VGaer/flatbox/hardware-rev5-rgb/pcb/BOM.csv

No. | Quantity | Comment | Designator | Footprint | Value | Manufacturer Part | Manufacturer | Supplier Part | Supplier
1 | 1 | RP2040-Zero_RP2040-Zero | A1 | RP2040-Zero:RP2040-Zero | RP2040-Zero
2 | 1 | 100nF | C1 | C0603 | 100nF
3 | 6 | Mechanical_MountingHole | H1,H2,H3,H4,H5,H6 | MountingHole:MountingHole_6.4mm_M6 | MountingHole
4 | 12 | WS2812B-2020 | LED1,LED2,LED3,LED4,LED5,LED6,LED7,LED8,LED9,LED10,LED11,LED12 | LED-SMD_4P-L2.0-W2.0-TL_WS2812B-2020 |  | WS2812B-2020 | worldsemi | C965555 | LCSC
5 | 1 | 10K | R1 | R0603 | 10K
6 | 7 | TS-1002-AR05026 | SW1,SW2,SW3,SW4,SW5,SW6,SW7 | Button_Switch_THT:SW_PUSH_6mm_H5mm | SW_Push | TS-1002-AR05026 | XUNPU(讯普) | C2835251 | LCSC
7 | 12 |  | U1,U2,U3,U4,U5,U6,U7,U8,U9,U10,U11,U12 | Kailh_socket_PG1350
8 | 1 | SN74LV1T34DBVR | U13 | SOT-23-5_L3.0-W1.7-P0.95-LS2.8-BR |  | SN74LV1T34DBVR | TI(德州仪器) | C100024 | LCSC
