VGaer/flatbox/hardware-rev5-rgb/extras/arc v4.dxf

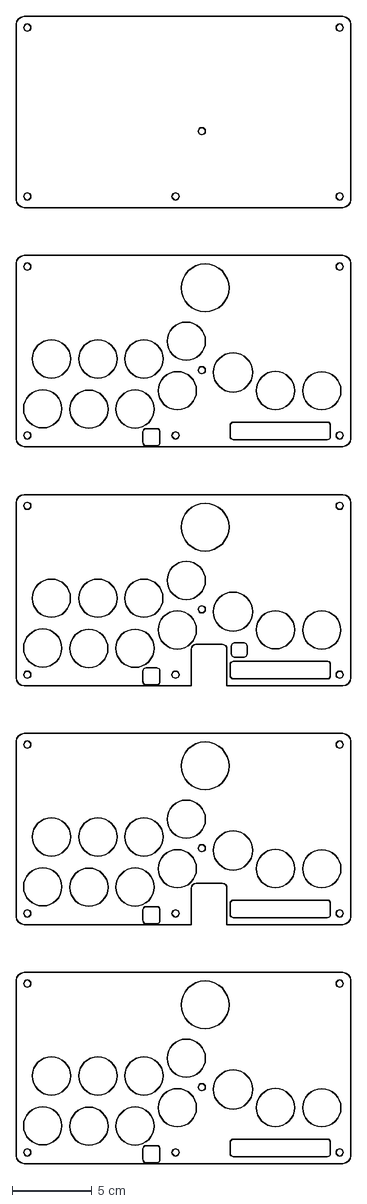
[picture p7: CAD file, 2023-06-08]
hardware-rev5-rgb/extras/arc v4.dxf
21.0 x 72.0 cm
