VGaer/flatbox/hardware-rev5-rgb/extras/Flatbox_cap_sprue.stl

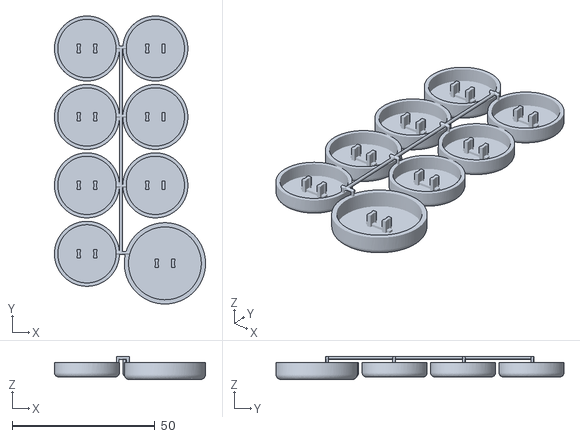
[picture p8: CAD file, 2023-06-07]
hardware-rev5-rgb/extras/Flatbox_cap_sprue.stl
53.0 x 101.0 x 8.12
