VGaer/flatbox/hardware-rev5-rgb/extras/test arc.dxf

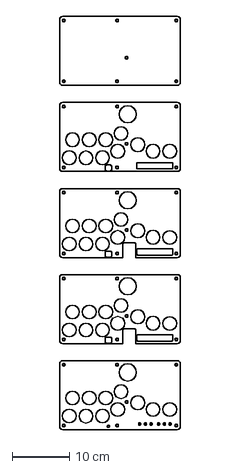
[picture p9: CAD file, 2023-05-07]
hardware-rev5-rgb/extras/test arc.dxf
21.0 x 72.0 cm
