VGaer/flatbox/hardware-rev5-rgb/extras/SCH_Schematic1_2023-03-26.pdf

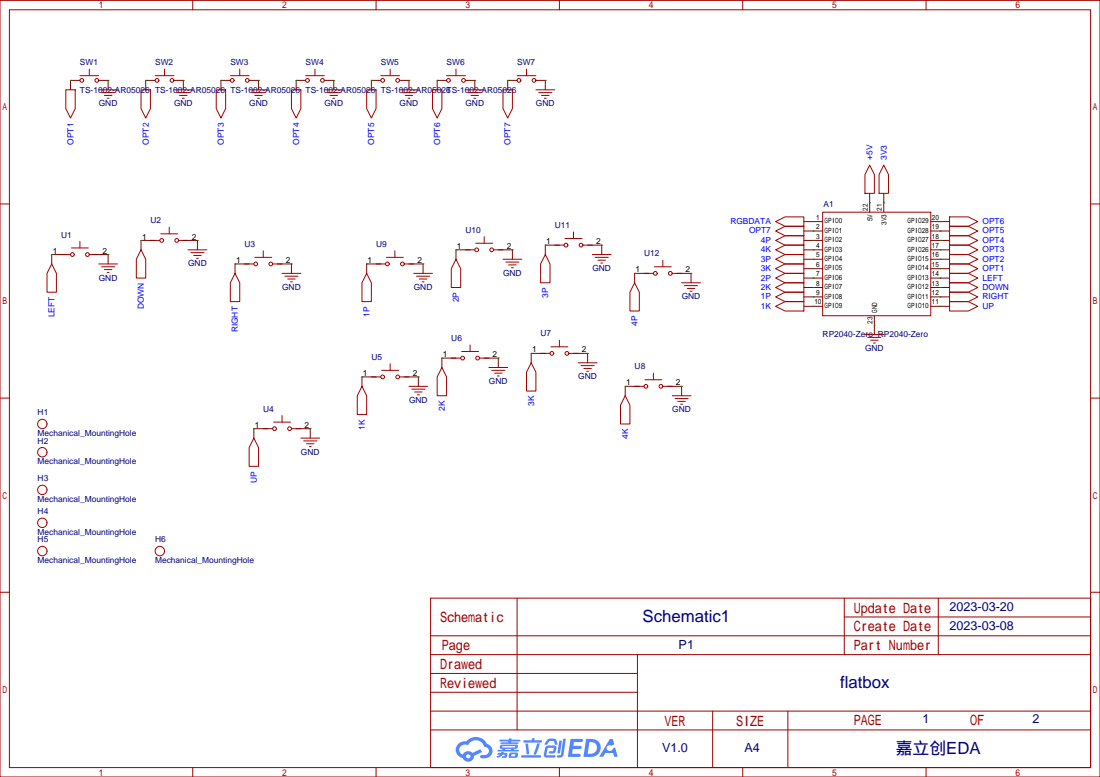
[picture p10: page 1]

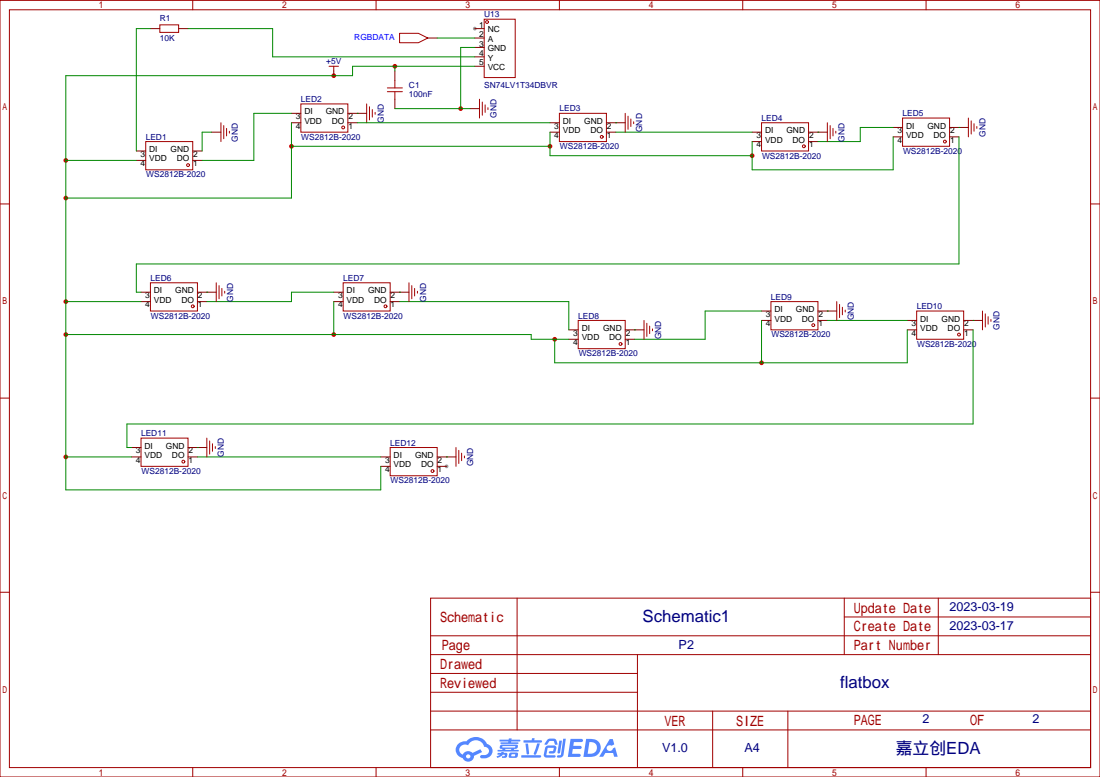
[picture p11: page 2]
