VGaer/flatbox/(commit log)

2023-03-17 rgb ver
    [BOM.csv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]
2023-03-18 update pcb
    [BOM.csv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]
2023-05-07 update arc
    [test arc.dxf]
2023-06-07 new arc
    [Flatbox_cap_sprue.stl]
