VGaer/flatbox/hardware-rev5-rgb/images/IMG_4921.JPG

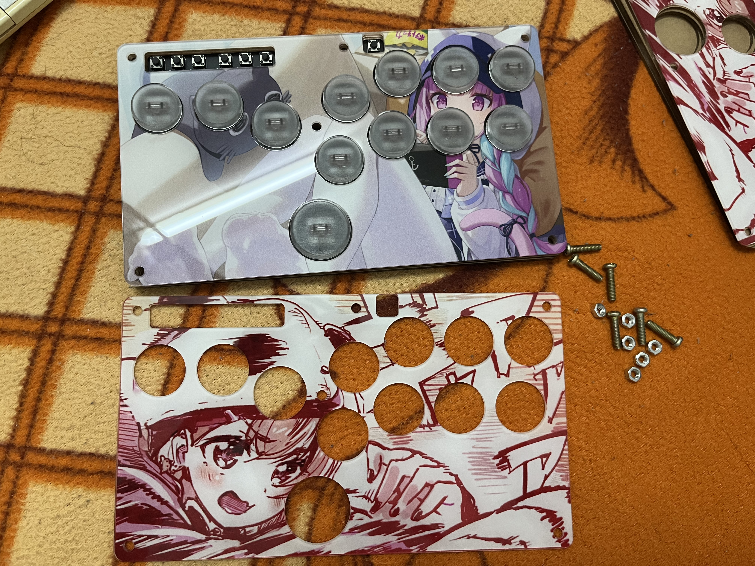
[picture p2: hardware-rev5-rgb/images/IMG_4921.JPG]
hardware-rev5-rgb/images/IMG_4921.JPG
